PetervandenDoel/soundLocalizationHardware/LT1568 4th order wide bandpass filter.asc

R2: res; 59k; tol=1
R3: res; 62k; tol=1
R4: res; 15k; tol=1
RB1: res; 30k; tol=1
U1: LT1568
V1: voltage; ""; AC 1
V2: voltage; 5
V3: voltage; -5
ZA1: cap; 0.1µ
ZA3: res; 59k; tol=1
ZAB1: cap; 100p
Named nets: 0, IN, OUT
.ac dec 100 100 1000000
.param fcHP=20K fcLP=50K
LT1568 - Very Low Noise, High Frequency Active RC, Filter Building Block
Wide Passband, 4th Order Bandpass
Notes: 
  Min R3 and R4 is 100ohms. See Demo Manual DC675B for details.
  If the simulation model is not found please update with the "Sync Release" command from the "Tools" menu.
  It remains the customer's responsibility to verify proper and reliable operation in the actual application.
  Component substitution and printed circuit board layout may significantly affect circuit performance or reliability.
  Contact your local sales representative for assistance. This circuit is distributed to customers only for use with LTC parts.
  Copyright © 2015 Linear Technology Inc.  All rights reserved.
