PetervandenDoel/soundLocalizationHardware/RLC_active_bandpassfilter.asc

C1: cap; 1µ
C2: cap; 1µ
C3: cap; 0.318n
C4: cap; 0.325n
C5: cap; 110n
C6: cap; 47n
C7: cap; 110n
C318: cap; 0.765n
c81293: cap; 0.759n
HighFreqC2: cap; 800p
HighFreqR2: res; 3978
L1: ind; 240µ
L2: ind; 240µ
L3: ind; 510µ
LowFreqC1: cap; 800n
LowFreqR1: res; 9.947
R1: res; 5.305
R2: res; 3.08
R3: res; 10.610
R3NF: res; 10.610
R4: res; 1k
R5: res; 10k
R6: res; 10k
R7: res; 50
R8: res; 50
R141380: res; 10k
R234819: res; 10k
R3934102: res; 1k
U1: AD795
U2: UniversalOpAmp4
V1: voltage; SINE(0 1 1k); AC 1 0
V2: voltage; 5
V3: voltage; 5
V4: voltage; SINE(0 1 1k); AC 1 0
V5: voltage; 5
V6: voltage; 5
V7: voltage; SINE(0 1 1k); AC 1 0
Vsource: voltage; SINE(0 1 1k); AC 1 0
Named nets: 0, out
.ac dec 100 10k 100k
