PetervandenDoel/soundLocalizationHardware/(list of files, drawings)

Other design files:
Fish shaped PCB/fish on its own.PrjPcb
Fish shaped PCB/thru hole LTC1562 8th order 4 LP or BP stages.SchDoc
Fish shaped PCB/Thru hole preamp with charge or INV stages with input resistors.SchDoc
hydrophone_preamp_and_filter.SchDoc
SMT system/CASCAD~1.PCB
SMT system/LTC1562 8th order 2 resistors per pin.SchDoc
SMT system/smt preamp with charge or INV stages with input resistors.SchDoc
Through Hole PCB/thru hole preamp amps and LP+BP filter stages.PrjPcb
