PetervandenDoel/soundLocalizationHardware/Filter tester pcb/readme.md

This circuit board was designed to test out two identical 4th order filters on the same PCB to characterize the difference in their phase response. This board has not been tested yet and for the time being phase response characterization can be done fine on the through hole boards.

For the surface mount designs 0402 SMD pads are placed at every node where a resistor or capacitor needs to be placed for configuring the filter. the reason why two sets of pads were routed is because standard resistor and capacitor values on their own do not allow for a good Bessel Butterworth or Chebyshev response at a sufficently customizable frequency. I found that I was able to get good Butterworth chebyshev and Bessel responses in simulations using standard resistor and capacitor values provide that I allowed myself to put two of them in series on each terminal.


The right combination of standard values can be acquired from an online calculator
